shackspace/Portal-v4/(list of files, drawings)

Other design files:
hardware/portal.dsn
