shackspace/Portal-v4/hardware/portal.kicad_pcb

## KiCad design hardware/portal.kicad_pcb (2018-05-10)

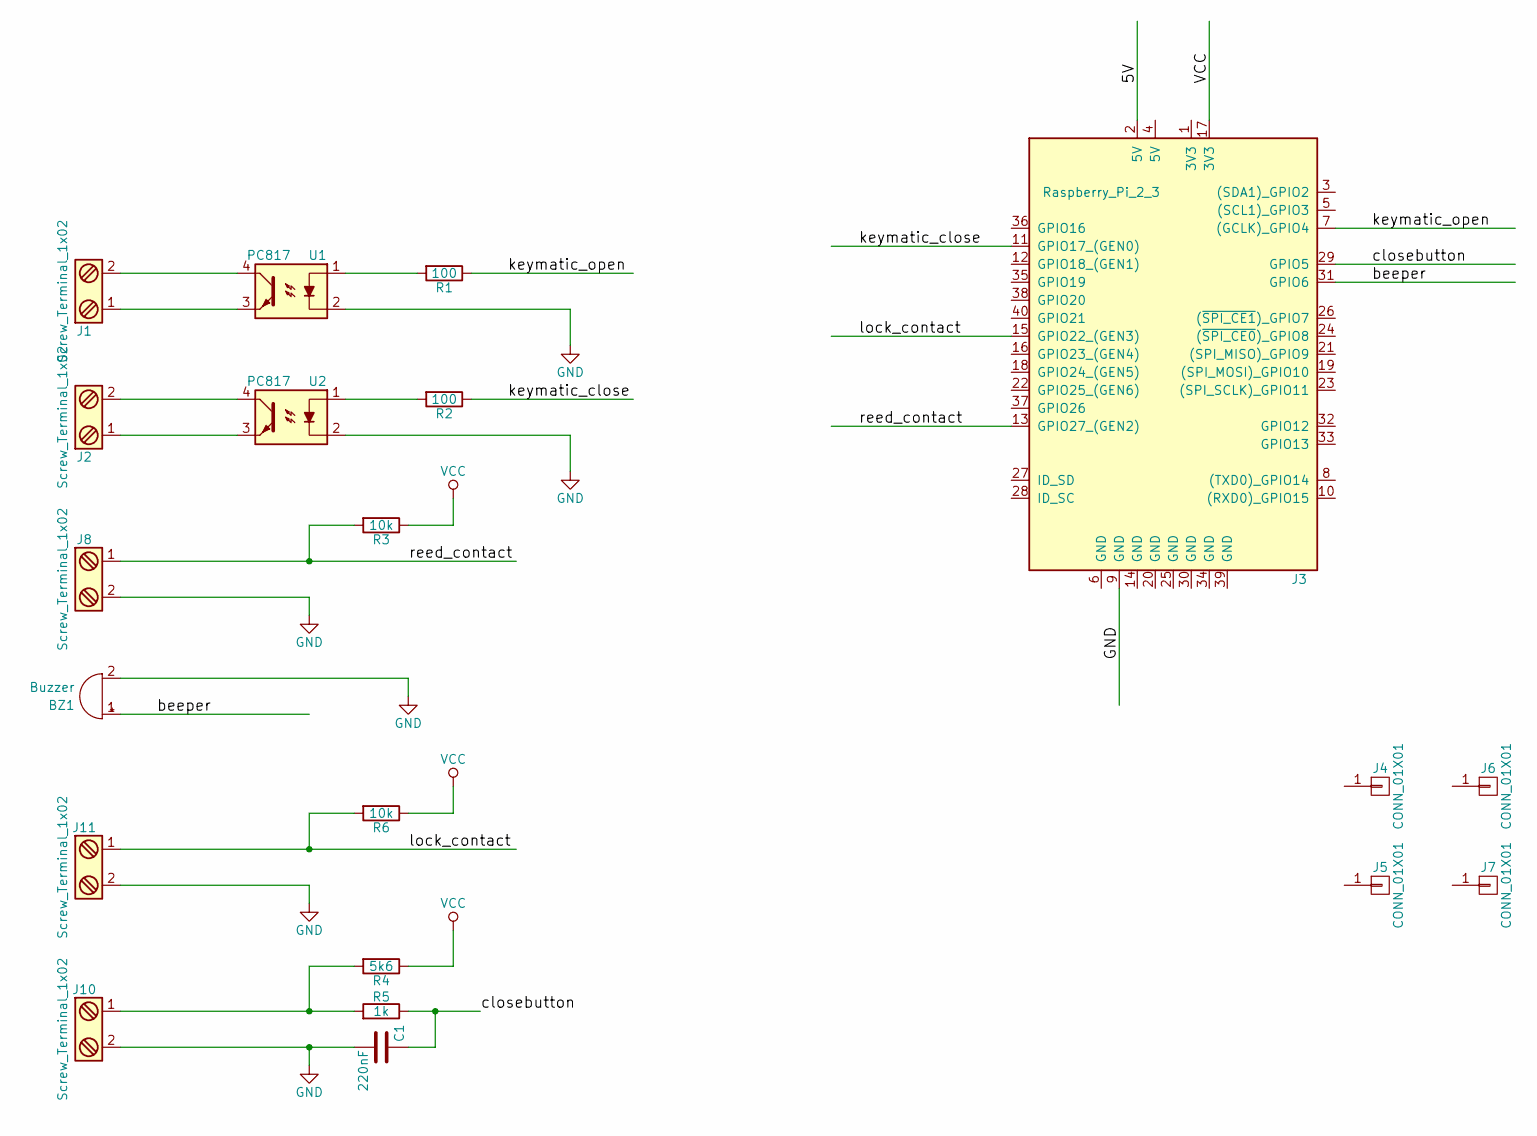
[picture p1: schematic portal.sch]

Parts:
BZ1: Buzzer; MagneticBuzzer_ProSignal_ABT-410-RC
C1: 220nF; C_0805_HandSoldering
J1, J2, J8, J10, J11: Screw_Terminal_1x02; SCREWTERMINAL-5MM-2
J3: Raspberry_Pi_2_3; Socket_Strip_Straight_2x20_Pitch2.54mm
J4, J5, J6, J7: CONN_01X01; MountingHole_2.7mm_M2.5
R1, R2: 100; R_0805_HandSoldering
R3, R6: 10k; R_0805_HandSoldering
R4: 5k6; R_0805_HandSoldering
R5: 1k; R_0805_HandSoldering
U1, U2: PC817; DIP-4_W7.62mm

Connections:
/5V: J3.2 (5V)
/beeper: BZ1.1 (-), J3.31 (GPIO6)
/closebutton: C1.1, J3.29 (GPIO5), R5.1
/keymatic_close: J3.11 (GPIO17_(GEN0)), R2.1
/keymatic_open: J3.7 ((GCLK)_GPIO4), R1.1
/lock_contact: J3.15 (GPIO22_(GEN3)), J11.1, R6.2
/reed_contact: J3.13 (GPIO27_(GEN2)), J8.1, R3.2
GND: BZ1.2 (+), C1.2, J3.9 (GND), J8.2, J10.2, J11.2, U1.2, U2.2
unnamed: J1.1, U1.3
unnamed: J1.2, U1.4
unnamed: J2.1, U2.3
unnamed: J2.2, U2.4
unnamed: J10.1, R4.2, R5.2
unnamed: R1.2, U1.1
unnamed: R2.2, U2.1
VCC: J3.17 (3V3), R3.1, R4.1, R6.1

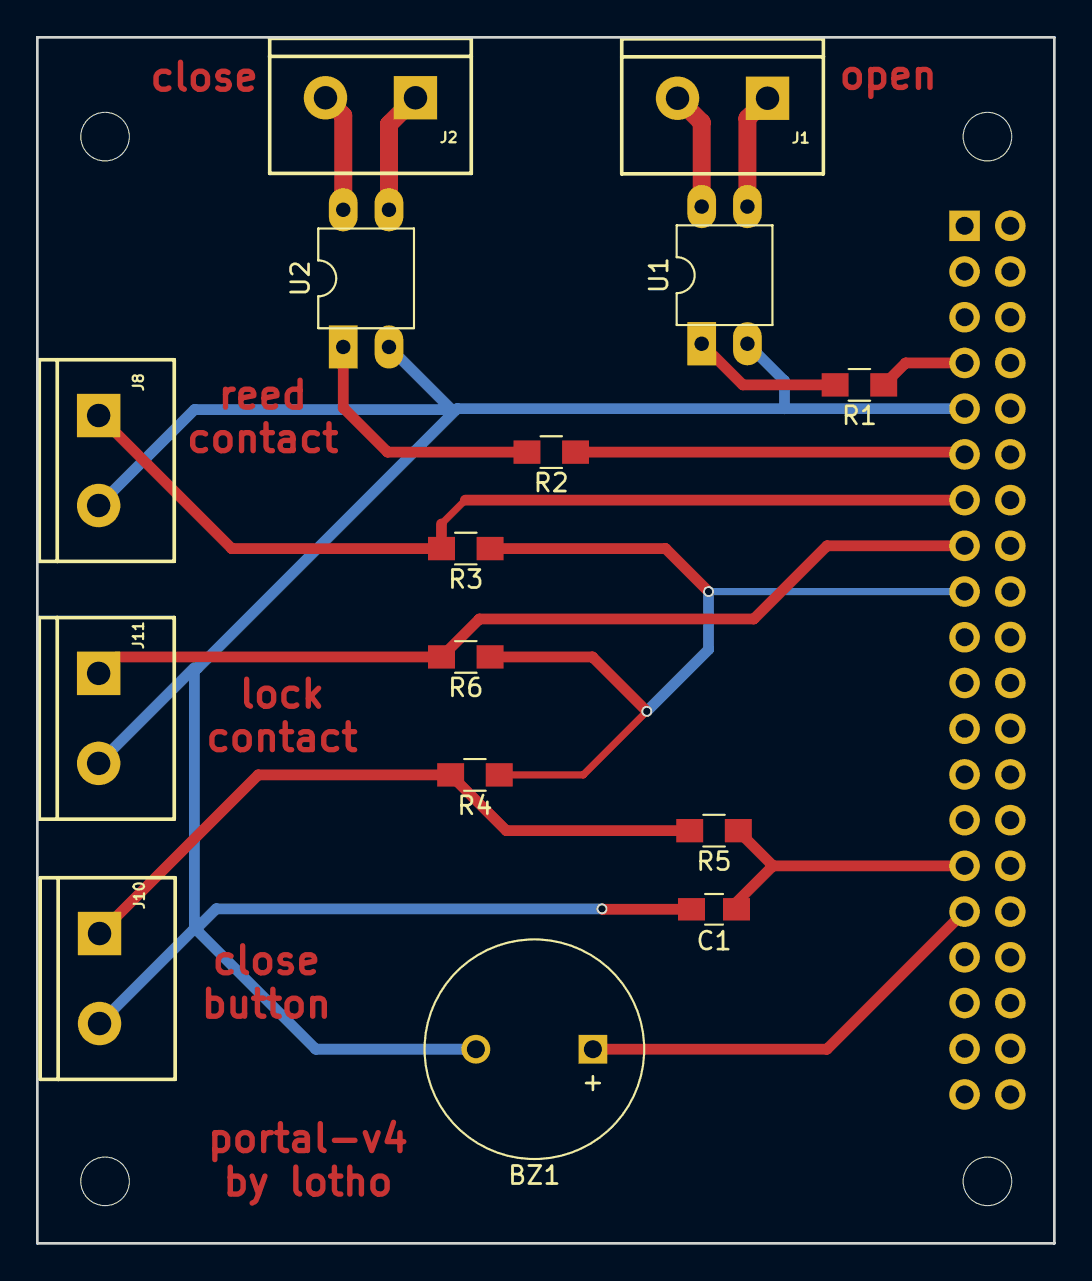
[picture p2: board portal.kicad_pcb from above]

Board: 2 copper layers, 56.5 x 67.0 mm, 20 parts (1 on the bottom side), 15 nets.
